fred314159265/current-probe/Current_Probe_CC6920B.kicad_pcb

## KiCad design Current_Probe_CC6920B.kicad_pcb (2024-10-12)

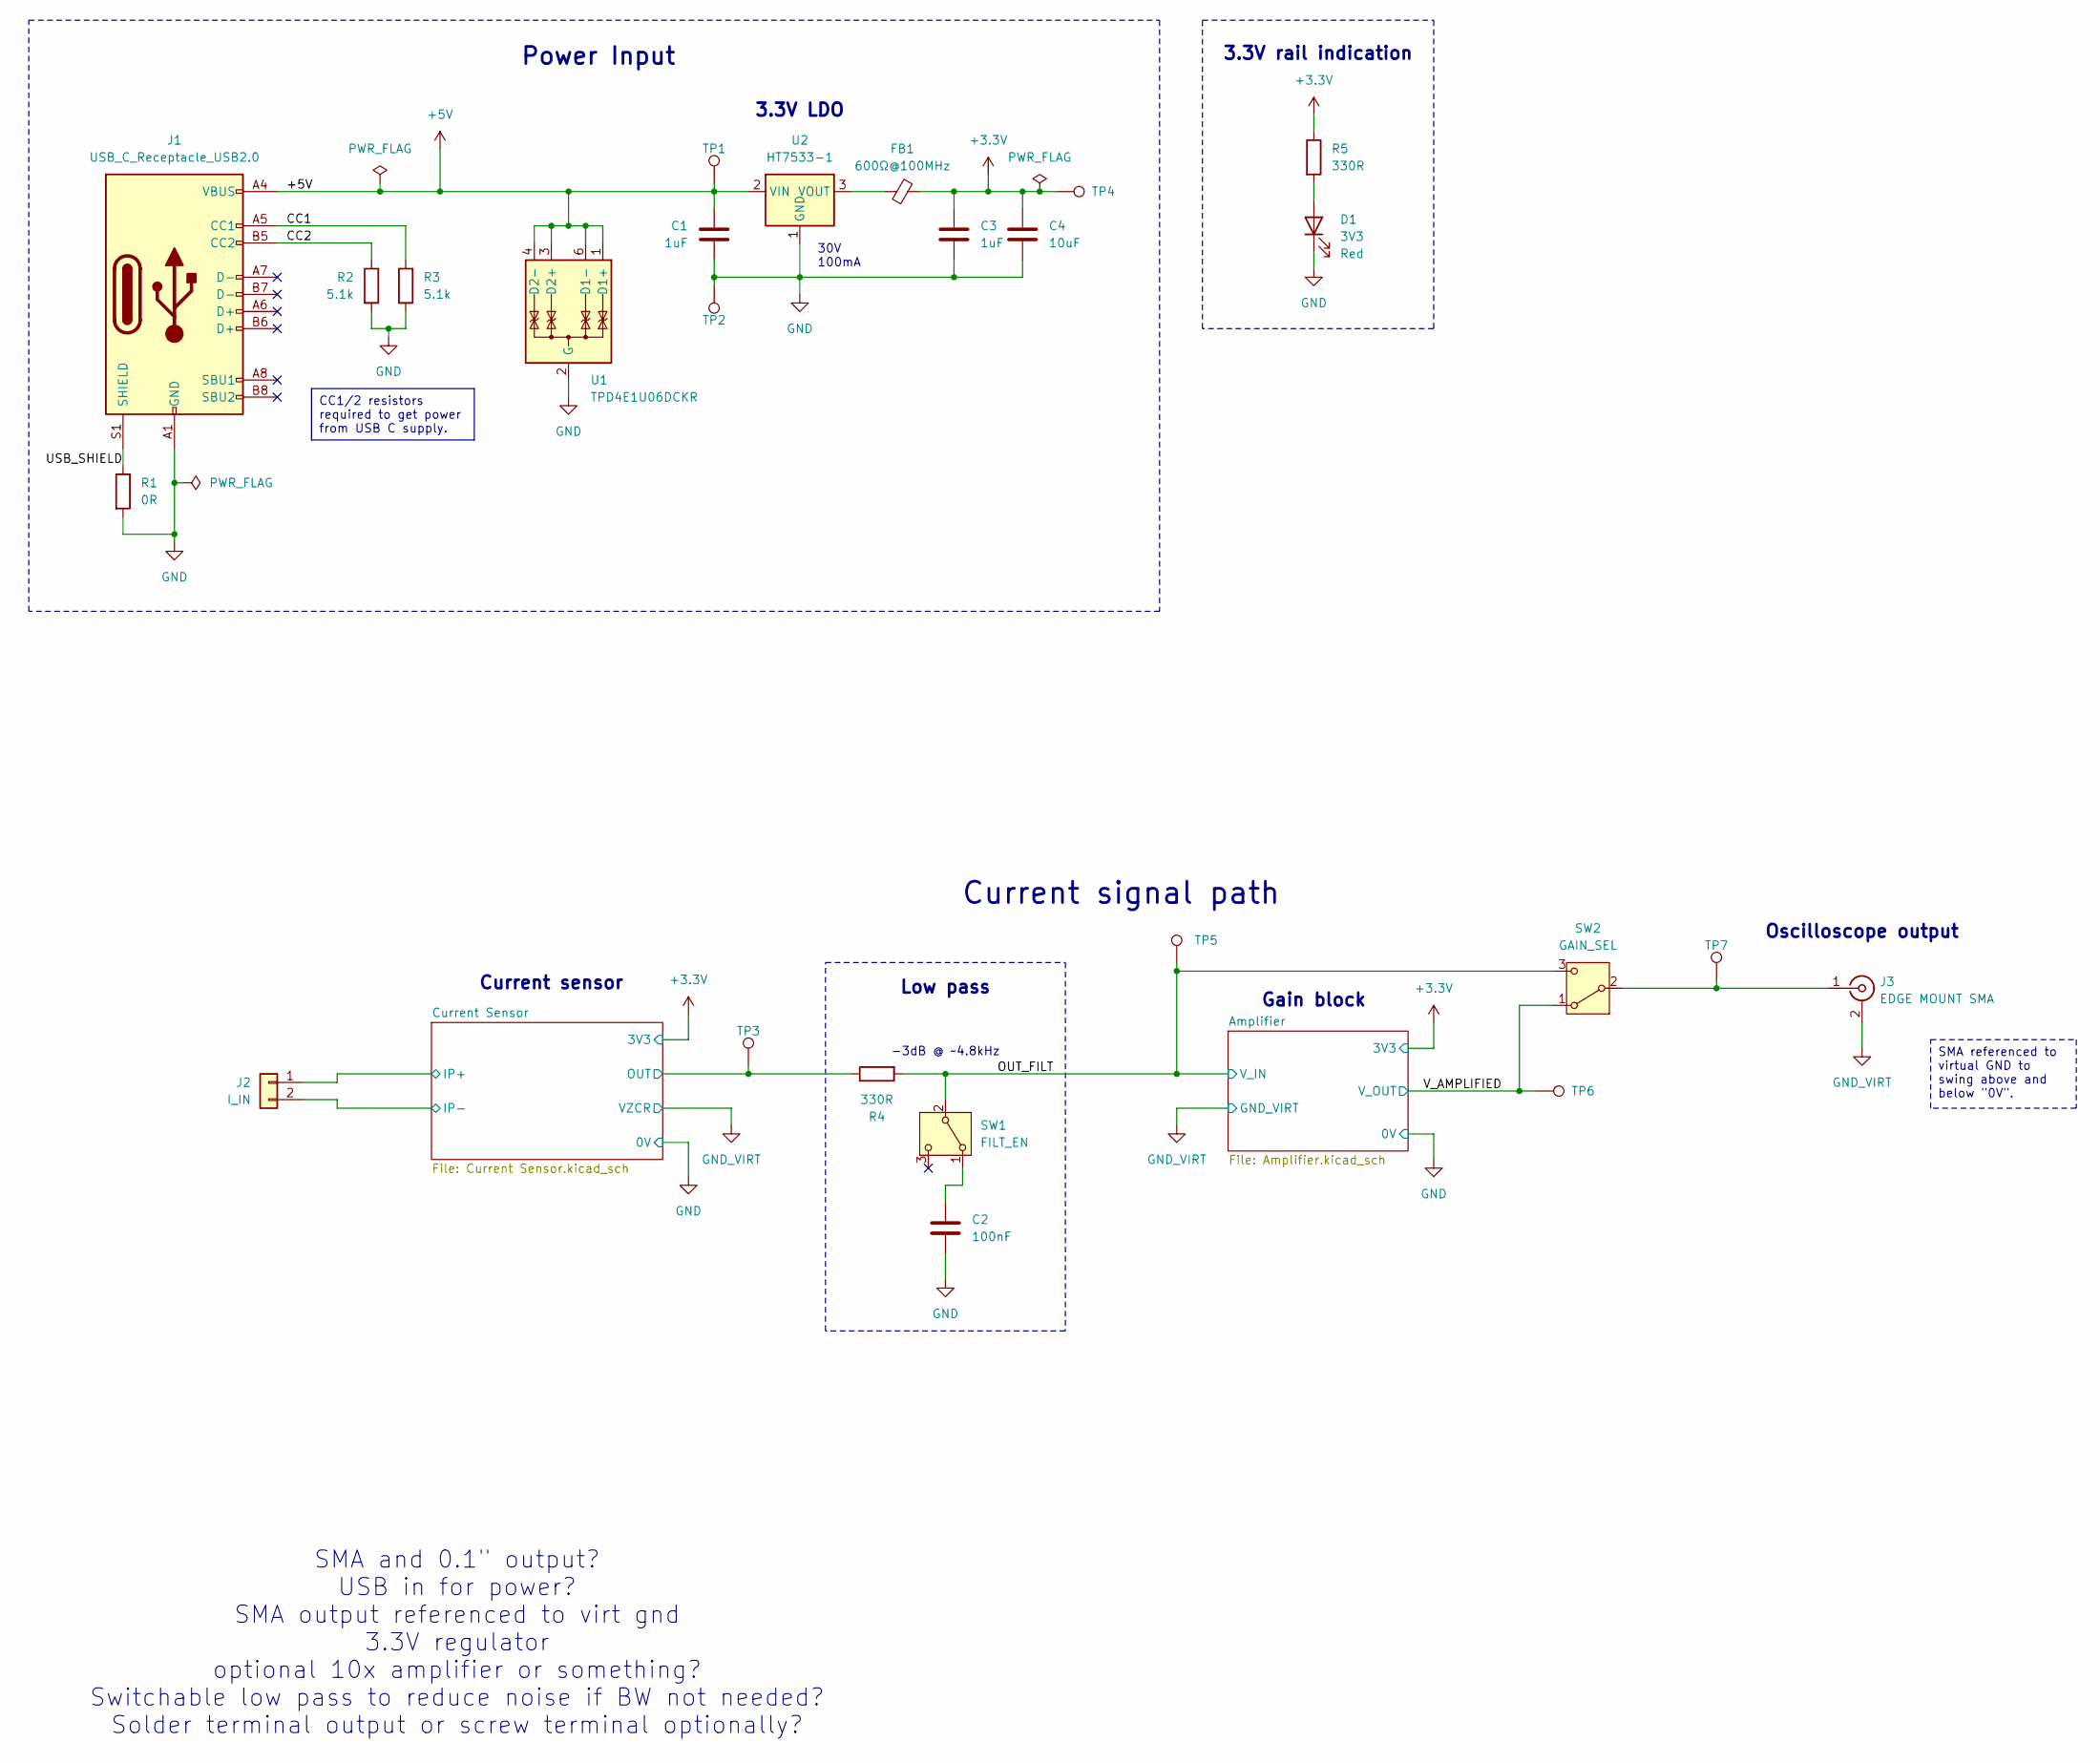
[picture p1: schematic Current_Probe_CC6920B.kicad_sch]

Parts:
C1, C3: 1uF; C_0805_2012Metric; Manufacturer Part # CL21B105KBFNNNE; LCSC Part # C28323
C2: 100nF; C_0603_1608Metric; Manufacturer Part # CC0603KRX7R9BB104; LCSC Part # C14663
C4: 10uF; C_0603_1608Metric; Manufacturer Part # CL10A106MA8NRNC; LCSC Part # C96446
D1: 3V3; LED_0603_1608Metric; Manufacturer Part # KT-0603R; LCSC Part # C2286
FB1: 600Ω@100MHz; L_0603_1608Metric; Manufacturer Part # GZ1608D601TF; LCSC Part # C1002
J1: USB_C_Receptacle_USB2.0; USB_C_Receptacle_XKB_U262-16XN-4BVC11; Manufacturer Part # U262-161N-4BVC11; LCSC Part # C319148
J2: I_IN; TerminalBlock_Phoenix_MKDS-1,5-2_1x02_P5.00mm_Horizontal; Manufacturer Part # WJ128V-5.0-2P; LCSC Part # C8269
J3: EDGE MOUNT SMA; SMA_Samtec_SMA-J-P-H-ST-EM1_EdgeMount; Manufacturer Part # BWSMA-KE-P001; LCSC Part # C496550
R1: 0R; R_0603_1608Metric; Manufacturer Part # 0603WAF0000T5E; LCSC Part # C21189
R2, R3: 5.1k; R_0603_1608Metric; Manufacturer Part # 0603WAF5101T5E; LCSC Part # C23186
R4, R5: 330R; R_0603_1608Metric; Manufacturer Part # 0603WAF3300T5E; LCSC Part # C23138
SW1: FILT_EN; SW_SPDT_PCM12; Manufacturer Part # SSSS811101; LCSC Part # C109335
SW2: GAIN_SEL; SW_SPDT_PCM12; Manufacturer Part # SSSS811101; LCSC Part # C109335
TP1, TP2, TP3, TP4, TP5, TP6, TP7: TestPoint; TestPoint_THTPad_1.0x1.0mm_Drill0.5mm
U1: TPD4E1U06DCKR; SOT-363_SC-70-6; LCSC Part # C194628
U2: HT7533-1; SOT-89-3; Manufacturer Part # HT7533-1; LCSC Part # C14289

Connections:
+3.3V: C3.1, C4.1, FB1.2, R5.1, TP4.1; also elsewhere on the board
+5V: C1.1, J1.A4 (VBUS), J1.A9 (VBUS), J1.B4 (VBUS), J1.B9 (VBUS), TP1.1, U1.1 (D1+), U1.3 (D2+), U1.4 (D2-), U1.6 (D1-), U2.2 (VIN)
/CC1: J1.A5 (CC1), R3.1
/CC2: J1.B5 (CC2), R2.1
/Current Sensor/IP+: J2.1; also elsewhere on the board
/Current Sensor/IP-: J2.2; also elsewhere on the board
/Current Sensor/OUT: R4.1, TP3.1; also elsewhere on the board
/OUT_FILT: R4.2, SW1.2 (B), SW2.3 (C), TP5.1; also elsewhere on the board
/USB_SHIELD: J1.S1 (SHIELD), R1.1
/V_AMPLIFIED: SW2.1 (A), TP6.1; also elsewhere on the board
GND: C1.2, C2.2, C3.2, C4.2, D1.1 (K), J1.A1 (GND), J1.A12 (GND), J1.B1 (GND), J1.B12 (GND), R1.2, R2.2, R3.2, TP2.1, U1.2 (G), U2.1 (GND); also elsewhere on the board
GND_VIRT: J3.2 (Ext); also elsewhere on the board
unnamed: D1.2 (A), R5.2
unnamed: J3.1 (In), SW2.2 (B), TP7.1
unnamed: C2.1, SW1.1 (A)
unnamed: FB1.1, U2.3 (VOUT)

Notes on the sheet:
CC1/2 resistors required to get power from USB C supply.
SMA referenced to virtual GND to swing above and below "0V".
30V 100mA
3.3V LDO
-3dB @ ~4.8kHz
Oscilloscope output
Low pass
3.3V rail indication
Power Input
SMA and 0.1" output? USB in for power? SMA output referenced to virt gnd 3.3V regulator optional 10x amplifier or something? Switchable low pass to reduce noise if BW not needed? Solder terminal output or screw terminal optionally?
Current sensor
Current signal path
Gain block

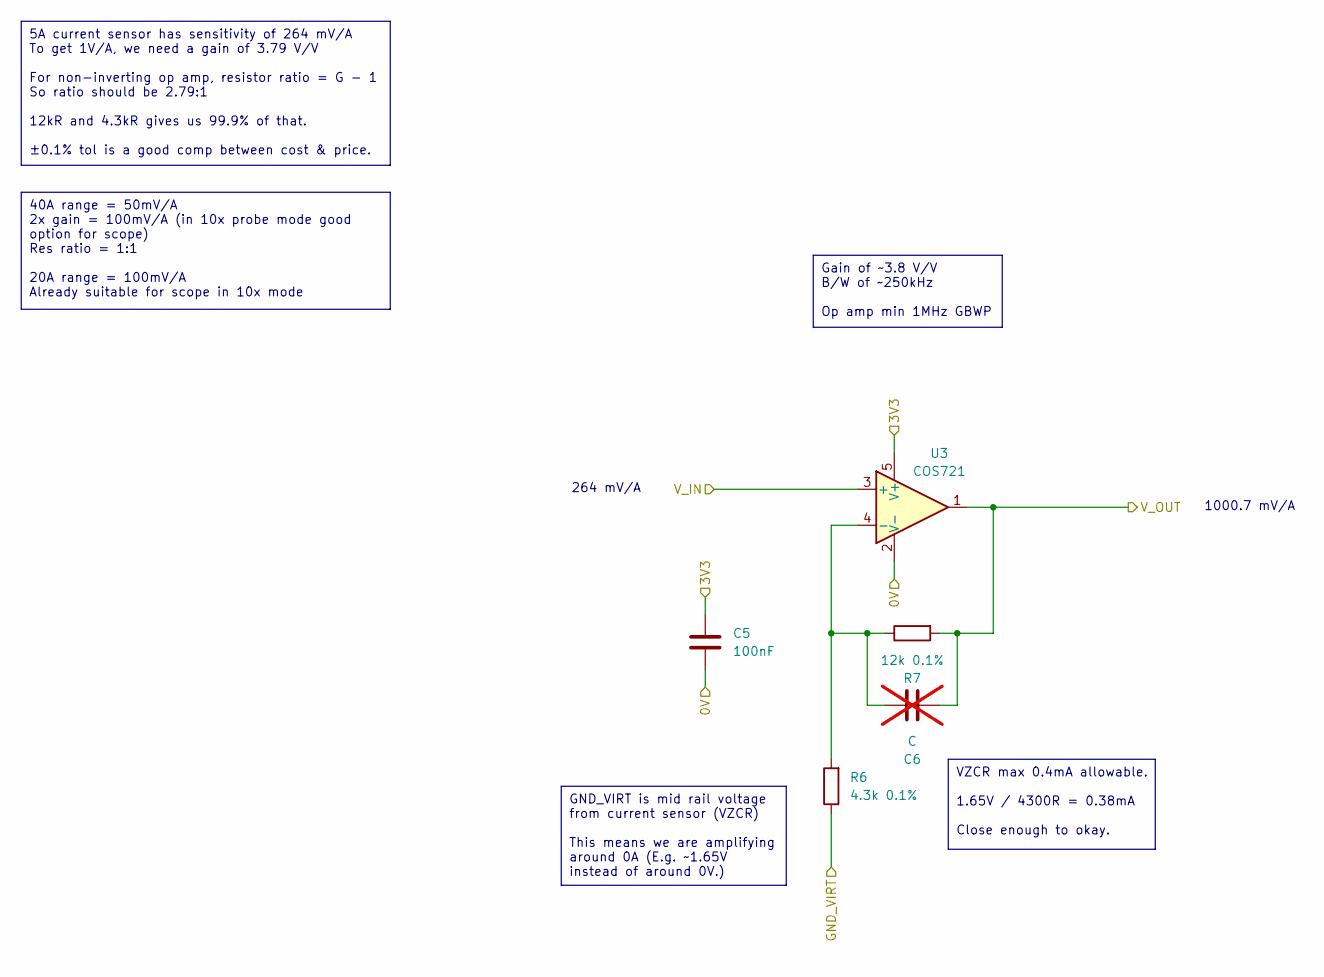
[picture p2: schematic Amplifier.kicad_sch]

Parts:
C5: 100nF; C_0603_1608Metric; Manufacturer Part # CC0603KRX7R9BB104; LCSC Part # C14663
C6: C; C_0603_1608Metric; not fitted
R6: 4.3k 0.1%; R_0603_1608Metric; Manufacturer Part # TD03G4301BT; LCSC Part # C666992
R7: 12k 0.1%; R_0603_1608Metric; Manufacturer Part # RT0603BRD0712KL; LCSC Part # C326735
U3: COS721; SOT-23-5; Manufacturer Part # COS721TR; LCSC Part # C693056

Connections:
+3.3V: C5.1, U3.5 (V+); also elsewhere on the board
/OUT_FILT: U3.3 (+); also elsewhere on the board
/V_AMPLIFIED: C6.2, R7.2, U3.1; also elsewhere on the board
GND: C5.2, U3.2 (V-); also elsewhere on the board
GND_VIRT: R6.1; also elsewhere on the board
unnamed: C6.1, R6.2, R7.1, U3.4 (-)

Notes on the sheet:
Gain of ~3.8 V/V B/W of ~250kHz Op amp min 1MHz GBWP
5A current sensor has sensitivity of 264 mV/A To get 1V/A, we need a gain of 3.79 V/V For non-inverting op amp, resistor ratio = G - 1 So ratio should be 2.79:1 12kR and 4.3kR gives us 99.9% of that. ±0.1% tol is a good comp between cost & price.
VZCR max 0.4mA allowable. 1.65V / 4300R = 0.38mA Close enough to okay.
GND_VIRT is mid rail voltage from current sensor (VZCR) This means we are amplifying around 0A (E.g. ~1.65V instead of around 0V.)
40A range = 50mV/A 2x gain = 100mV/A (in 10x probe mode good option for scope) Res ratio = 1:1 20A range = 100mV/A Already suitable for scope in 10x mode
264 mV/A
1000.7 mV/A

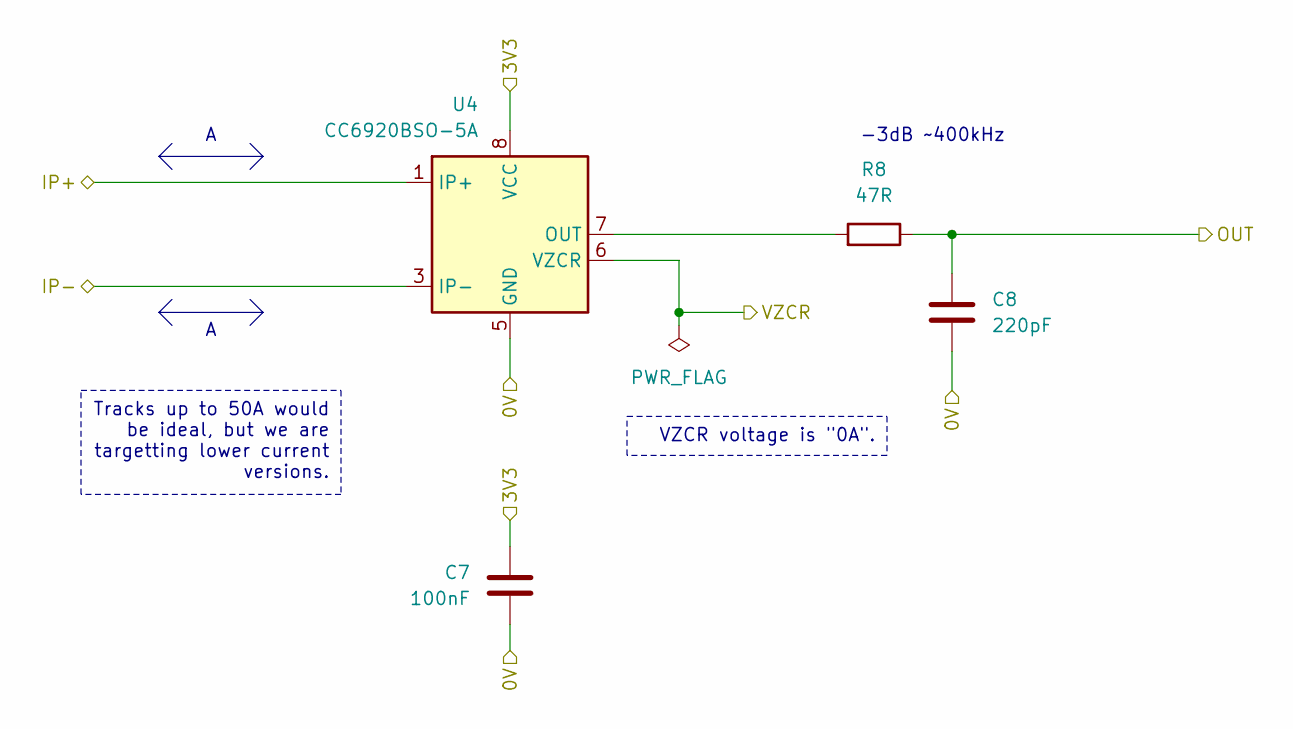
[picture p3: schematic Current Sensor.kicad_sch]

Parts:
C7: 100nF; C_0603_1608Metric; Manufacturer Part # CC0603KRX7R9BB104; LCSC Part # C14663
C8: 220pF; C_0603_1608Metric; Manufacturer Part # CL10B221KB8NNNC; LCSC Part # C1603
R8: 47R; R_0603_1608Metric; Manufacturer Part # 0603WAF470JT5E; LCSC Part # C23182
U4: CC6920BSO-5A; SOIC-8_3.9x4.9mm_P1.27mm; Manufacturer Part # CC6920BSO-5A; LCSC Part # C2880430

Connections:
+3.3V: C7.1, U4.8 (VCC); also elsewhere on the board
/Current Sensor/IP+: U4.1 (IP+), U4.2 (IP+); also elsewhere on the board
/Current Sensor/IP-: U4.3 (IP-), U4.4 (IP-); also elsewhere on the board
/Current Sensor/OUT: C8.1, R8.1; also elsewhere on the board
GND: C7.2, C8.2, U4.5 (GND); also elsewhere on the board
GND_VIRT: U4.6 (VZCR); also elsewhere on the board
unnamed: R8.2, U4.7 (OUT)

Notes on the sheet:
VZCR voltage is "0A".
Tracks up to 50A would be ideal, but we are targetting lower current versions.
-3dB ~400kHz

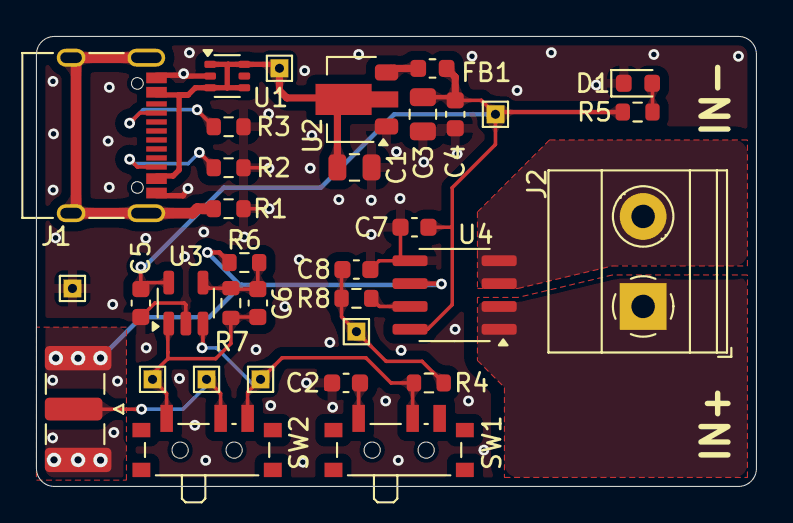
[picture p4: board Current_Probe_CC6920B.kicad_pcb from above]

Board: 2 copper layers, 40.0 x 25.0 mm, 34 parts (0 on the bottom side), 18 nets.
