fred314159265/current-probe/(commit log)

2024-09-25 Started work on the design.
    [Amplifier.kicad_sch, Current_Probe_CC6920B.kicad_pcb, Current_Probe_CC6920B.kicad_sch]
2024-09-26 Schematic mostly done?
    [Amplifier.kicad_sch, Current Sensor.kicad_sch, Current_Probe_CC6920B.kicad_pcb, Current_Probe_CC6920B.kicad_sch]
2024-09-28 Working on the layout
    [Amplifier.kicad_sch, Current Sensor.kicad_sch, Current_Probe_CC6920B.kicad_pcb, Current_Probe_CC6920B.kicad_sch]
2024-10-12 Rev A sent for manufacture.
    [Amplifier.kicad_sch, Current_Probe_CC6920B.kicad_pcb]
